samchin/sound2haptic/electronics/v2-soundcard-haptic-driver/altium/Project Outputs for ResEnvAudioBoard/Report Board Stack/AudioPCB.xls

Board Stack Report
Stack Up |  | Layer Stack
Layer | Board Layer Stack | Name | Material | Thickness | Constant
1 |  | Top Overlay |  | 0mil
2 |  | Top Solder | Solder Resist | 1.2mil | 3.8
3 |  | Top Layer |  | 1.378mil
4 |  | Dielectric 2 | PP-006 | 8.284mil | 4.4
5 |  | GND | CF-004 | 0.598mil
6 |  | Dielectric 1 |  | 41.929mil | 4.6
7 |  | Power | CF-004 | 0.598mil
8 |  | Dielectric 3 | PP-006 | 8.284mil | 4.4
9 |  | Bottom Layer |  | 1.378mil
10 |  | Bottom Solder | Solder Resist | 1.2mil | 3.8
11 |  | Bottom Overlay |  | 0mil
 | Height : 64.849mil
