samchin/sound2haptic/electronics/v2-soundcard-haptic-driver/altium/Project Outputs for ResEnvAudioBoard/BOM/Bill of Materials-ResEnvAudioBoard(No Pop CM6206 Board).xlsx

Designator | Comment | Description | Quantity | Footprint | Manufacturer Part Number | Fitted
C1, C5, C10, C13, C19 | 10µF | CAP TANT 10UF 16V 20% 1206 | 5 | 1206 TANT CASE A | T491A106M016AT | Fitted
C2, C3, C4, C14, C16, C17, C20 | 0.1uF |  | 5 | 0603 |  | Fitted, Not Fitted
C6 | .1uF |  | 1 | 0603 |  | Fitted
C7, C8 | 6pF |  | 2 | 0603 |  | Fitted
C9 | 22 µF | CAP TANT 22UF 10% 10V 1411 | 1 | CAP POL 1411_3528 |  | Fitted
C11 | 2.2uF |  | 1 | 0603 |  | Fitted
C12, C21_C1, C21_C2, C21_C3, C21_C4, C21_C5, C21_C6, C21_C7, C21_C8, C22_C1, C22_C2, C22_C3, C22_C4, C22_C5, C22_C6, C22_C7, C22_C8, C23_C1, C23_C2, C23_C3, C23_C4, C23_C5, C23_C6, C23_C7, C23_C8, C24_C1, C24_C2, C24_C3, C24_C4, C24_C5, C24_C6, C24_C7, C24_C8, C25_C1, C25_C2, C25_C3, C25_C4, C25_C5, C25_C6, C25_C7, C25_C8, C26_C1, C26_C2, C26_C3, C26_C4, C26_C5, C26_C6, C26_C7, C26_C8, C27, C28, C29 | 1uF |  | 52 | 0603 |  | Fitted
C15, C18 | 10uF | CAP TANT 10UF 16V 20% 1206 | 2 | 1206 TANT CASE A | T491A106M016AT | Fitted
D1, D2 | MM3Z5V6ST1G | DIODE ZENER 5.6V 300MW SOD323 | 2 | FP-477-02-MFG |  | Fitted
D3 | LTST-C190KGKT | LED GREEN CLEAR 0603 SMD | 1 | LED_LTST-C190 | LTST-C190KGKT | Fitted
D4 | LB Q39G-L2OO-35-1 | LED BLUE DIFFUSED 0603 SMD | 1 | LB Q39G_BLUE | LB Q39G-L2OO-35-1 | Fitted
D5 | 5V | WE-TVS TVS Diode – High Speed Series, SOT23-5L, 2+1 Channel, 5V, 2pF | 1 | WE-TVS_SOT23-5L | 824011 | Fitted
FB1, FB2 | BLM18KG601SN1D | Chip Ferrite Bead, 0603, 600Ω @ 100MHz, 0.15Ω, 25%, 1.3A | 2 | FP-BLM18-0_15-t0_8-IPC_A |  | Fitted
FB3, FB4, FB5 | 742792609 |  | 3 | WE-CBF_0603_L1.6W0.8H0.8_HC |  | Fitted
J1 | UJ2-BH-W1-TH | 3 µin Plating Thickness, White Insulator, USB Receptacle | 0 | CUI_UJ2-BH-W1-TH |  | Not Fitted
J1_C1, J1_C2, J1_C3, J1_C4, J1_C5, J1_C6, J1_C7, J1_C8 | 1881558 |  | 0 | 1881558 |  | Not Fitted
J2 | TS-106-T-A | No Description Available | 0 | CON6_1X6_TU_HTS_SAI |  | Not Fitted
J3 | M20-9990246 | CONN HEADER VERT 2POS 2.54MM | 0 | FP-M20-9990246-MFG | M20-9990246 | Not Fitted
JP1 | 2 way jumper |  | 0 | 0603 2 way jumper |  | Not Fitted
Q1 | DMG2301L-7 | MOSFET P-CH 20V 3A SOT23 | 1 | FP-SOT23-MFG | DMG2301L-7 | Fitted
R1, R2 | 22 |  | 2 | 0603 |  | Fitted
R3 | 1k |  | 1 | 0603 |  | Fitted
R4, R5 | 330 |  | 2 | 0603 |  | Fitted
R6 | 63.4k |  | 1 | 0603 |  | Fitted
R7 | 10k |  | 1 | 0603 |  | Fitted
R8 | 1.5k |  | 1 | 0603 |  | Fitted
R9_C1, R9_C2, R9_C3, R9_C4, R9_C5, R9_C6, R9_C7, R9_C8, R10_C1, R10_C2, R10_C3, R10_C4, R10_C5, R10_C6, R10_C7, R10_C8, R12_C1, R12_C2, R12_C3, R12_C4, R12_C5, R12_C6, R12_C7, R12_C8 | 20k |  | 24 | 0603 |  | Fitted
R11_C1, R11_C2, R11_C3, R11_C4, R11_C5, R11_C6, R11_C7, R11_C8 | 0.25 |  | 8 | 0805_HV |  | Fitted
R13_C1, R13_C2, R13_C3, R13_C4, R13_C5, R13_C6, R13_C7, R13_C8 | 0 |  | 8 | 0603 |  | Fitted
S1, S2, S3, S4 | B3S-1000 |  | 4 | B3S-1000_OMR |  | Fitted
TP1, TP2, TP3, TP4, TP5, TP6, TP7, TP8, TP9, TP10, TP11, TP12, TP13, TP14, TP15, TP16, TP17_C1, TP17_C2, TP17_C3, TP17_C4, TP17_C5, TP17_C6, TP17_C7, TP17_C8 | 5001 | TEST POINT PC MINI .040"D BLACK | 24 | Testpoint pad | 5001 | Fitted
U1 | CM6206 |  | 0 | CM6206 LQFP48 |  | Not Fitted
U2 | 93C46C-I/SN | 1K, 128x8 or 64x16-bit, 5.0V Microwire Serial EEPROM, 8-Pin SOIC 150mil, Industrial Temperature | 0 | SOIC-SN8_N |  | Not Fitted
U3_C1, U3_C2, U3_C3, U3_C4, U3_C5, U3_C6, U3_C7, U3_C8 | TPA6211A1DGN | 3.1-W, mono, analog input Class-AB audio amplifier | 8 | SOP65P490X110-9N |  | Fitted
U4_C1, U4_C2, U4_C3, U4_C4, U4_C5, U4_C6, U4_C7, U4_C8 | INA180A1IDBVT | 26V, 350kHz current sense amplifier | 8 | SOT95P280X145-5N |  | Fitted
U5 | TLV75801PDBVR | 500-mA, low-IQ, high-accuracy, adjustable ultra-low-dropout voltage regulator with enable | 1 | SOT95P280X145-5N |  | Fitted
U6 | 113991054 | - ESP32-C3 Transceiver; 802.11 a/b/g/n (Wi-Fi, WiFi, WLAN), BluetoothÂ® Smart 4.x Low Energy (BLE) 2.4GHz Evaluation Board | 0 | 113991054 |  | Not Fitted
U7 | AP2127K-3.3TRG1 | IC REG LINEAR 3.3V 300MA SOT23-5 | 1 | FP-SOT25-MFG | AP2127K-3.3TRG1 | Fitted
X1 | ECS-120-8-36-CKM-TR3 | No Description Available | 1 | ECS-120-8_ECS |  | Fitted
