samchin/sound2haptic/electronics/v1-haptic-driver/haptics_driver.step

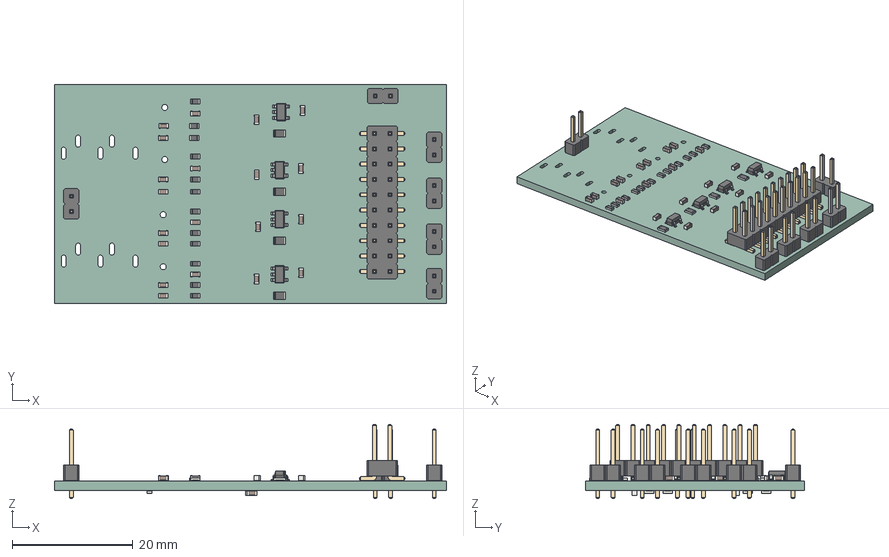
[picture p1: CAD file, 2025-09-18]
electronics/v1-haptic-driver/haptics_driver.step
65.0 x 36.3 x 12.3 mm
C_0603_1608Metric x 22
R_0603_1608Metric x 16
R_0805_2012Metric x 4
SOT_23_5 x 4
PinHeader_1x02_P254mm_Vertical x 6
PinHeader_2x10_P254mm_Vertical_SMD
haptics_driver_PCB
