samchin/sound2haptic/electronics/v2-soundcard-haptic-driver/case/case-body.stl

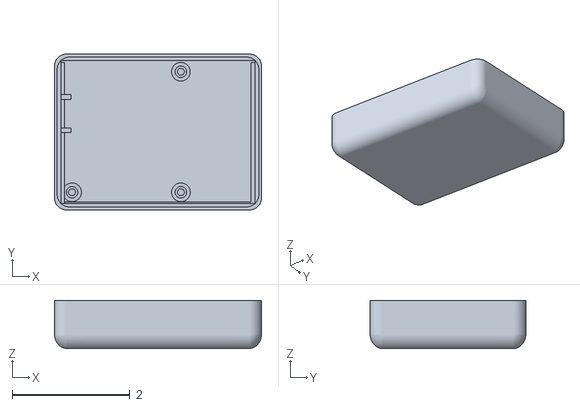
[picture p2: CAD file, 2025-09-18]
electronics/v2-soundcard-haptic-driver/case/case-body.stl
3.52 x 2.65 x 0.818
