samchin/sound2haptic/electronics/v2-soundcard-haptic-driver/case/case-cap.stl

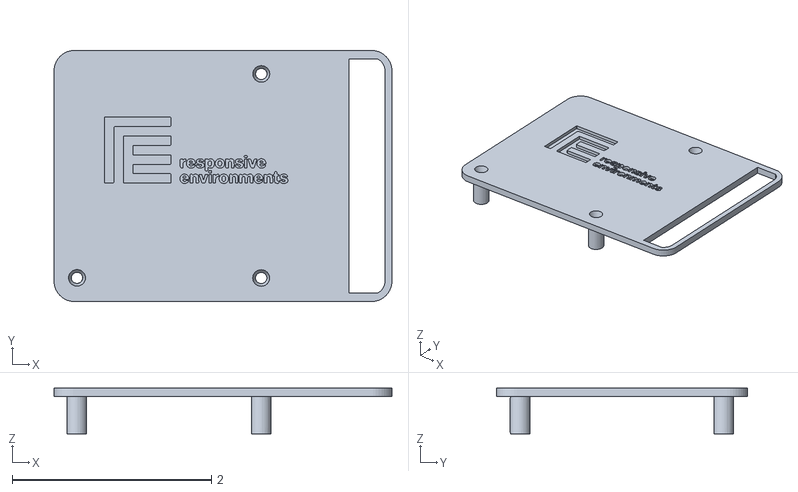
[picture p3: CAD file, 2025-09-18]
electronics/v2-soundcard-haptic-driver/case/case-cap.stl
3.39 x 2.52 x 0.46
