samchin/sound2haptic/electronics/v2-soundcard-haptic-driver/altium/Project Outputs for ResEnvAudioBoard/Job1.PDF

Designator | Comment | Description | Quantity | Footprint | Manufacturer Part Number | Fitted
C1, C5, C10, C13, C19 | 10µF | CAPTANT10UF16V 20%1206 | | 5 1206TANTCASEA | T491A106M016AT | Fitted
C2, C3, C4, C14, C16, C17, C20 | 0.1uF | | | 5 0603 | | Fitted, Not Fitted
C6 | .1uF | | | 1 0603 | | Fitted
C7, C8 | 6pF | | | 2 0603 | | Fitted
C9 | 22µF | CAPTANT22UF10% 10V1411 | | 1 CAPPOL1411_3528 | | Fitted
C11 | 2.2uF | | | 1 0603 | | Fitted
C12, C21_C1, C21_C2, C21_C3, C21_C4, C21_C5, C21_C6, C21_C7, C21_C8, C22_C1, C22_C2, C22_C3, C22_C4, C22_C5, C22_C6, C22_C7, C22_C8, C23_C1, C23_C2, C23_C3, C23_C4, C23_C5, C23_C6, C23_C7, C23_C8, C24_C1, C24_C2, C24_C3, C24_C4, C24_C5, C24_C6, C24_C7, C24_C8, C25_C1, C25_C2, C25_C3, C25_C4, C25_C5, C25_C6, C25_C7, C25_C8, C26_C1, C26_C2, C26_C3, C26_C4, C26_C5, C26_C6, C26_C7, C26_C8, C27, C28, C29 | 1uF | | 52 | 0603 | | Fitted
C15, C18 | 10uF | CAPTANT10UF16V 20%1206 | | 2 1206TANTCASEA | T491A106M016AT | Fitted
D1, D2 | MM3Z5V6ST1G | DIODEZENER5.6V 300MWSOD323 | | 2 FP-477-02-MFG | | Fitted
D3 | LTST-C190KGKT | LEDGREENCLEAR 0603SMD | | 1 LED_LTST-C190 | LTST-C190KGKT | Fitted
D4 | LBQ39G-L2OO-35-1 | LEDBLUEDIFFUSED 0603SMD | | 1 LBQ39G_BLUE | LBQ39G-L2OO-35-1 | Fitted
D5 | 5V | WE-TVSTVSDiode– HighSpeedSeries, SOT23-5L, 2+1 Channel, 5V, 2pF | | 1 WE-TVS_SOT23-5L | 824011 | Fitted
FB1, FB2 | BLM18KG601SN1D | ChipFerriteBead, 0603, 600Ω@ 100MHz, 0.15Ω, 25%, 1.3A | | 2 FP-BLM18-0_15-t0_8-IPC_A | | Fitted
FB3, FB4, FB5 | 742792609 | | | WE-3 CBF_0603_L1.6W0.8H 0.8_HC | | Fitted
J1 | UJ2-BH-W1-TH | 3µinPlating Thickness, White Insulator, USB Receptacle | | 0 CUI_UJ2-BH-W1-TH | | Not Fitted
J1_C1, J1_C2, J1_C3, J1_C4, J1_C5, J1_C6, J1_C7, J1_C8 | 1881558 | | | 0 1881558 | | Not Fitted
J2 | TS-106-T-A | NoDescription Available | | 0 CON6_1X6_TU_HTS_S AI | | Not Fitted
J3 | M20-9990246 | CONNHEADERVERT 2POS2.54MM | | 0 FP-M20-9990246-MFG | M20-9990246 | Not Fitted
JP1 | 2wayjumper | | | 0 06032wayjumper | | Not Fitted
Q1 | DMG2301L-7 | MOSFETP-CH20V3A SOT23 | | 1 FP-SOT23-MFG | DMG2301L-7 | Fitted
R1, R2 | 22 | | | 2 0603 | | Fitted
R3 | 1k | | | 1 0603 | | Fitted
R4, R5 | 330 | | | 2 0603 | | Fitted
R6 | 63.4k | | | 1 0603 | | Fitted
R7 | 10k | | | 1 0603 | | Fitted
R8 | 1.5k | | | 1 0603 | | Fitted
R9_C1, R9_C2, R9_C3, R9_C4, R9_C5, R9_C6, R9_C7, R9_C8, R10_C1, R10_C2, R10_C3, R10_C4, R10_C5, R10_C6, R10_C7, R10_C8, R12_C1, R12_C2, R12_C3, R12_C4, R12_C5, R12_C6, R12_C7, R12_C8 | 20k | | 24 | 0603 | | Fitted
R11_C1, R11_C2, R11_C3, R11_C4, R11_C5, R11_C6, R11_C7, R11_C8 | 0.25 | | | 8 0805_HV | | Fitted
R13_C1, R13_C2, R13_C3, R13_C4, R13_C5, R13_C6, R13_C7, R13_C8 | 0 | | | 8 0603 | | Fitted
S1, S2, S3, S4 | B3S-1000 | | | 4 B3S-1000_OMR | | Fitted
TP1, TP2, TP3, TP4, TP5, TP6, TP7, TP8, TP9, TP10, TP11, TP12, TP13, TP14, TP15, TP16, TP17_C1, TP17_C2, TP17_C3, TP17_C4, TP17_C5, TP17_C6, TP17_C7, TP17_C8 | 5001 | TESTPOINTPCMINI .040"DBLACK | 24 | Testpoint pad | 5001 | Fitted
U1 | CM6206 | | | 0 CM6206LQFP48 | | Not Fitted
U2 | 93C46C-I/SN | 1K, 128x8or 64x16-bit, 5.0VMicrowireSerial EEPROM, 8-PinSOIC 150mil, Industrial Temperature | | 0 SOIC-SN8_N | | Not Fitted
U3_C1, U3_C2, U3_C3, U3_C4, U3_C5, U3_C6, U3_C7, U3_C8 | TPA6211A1DGN | 3.1-W, mono, analog input Class-ABaudio amplifier | | 8 SOP65P490X110-9N | | Fitted
U4_C1, U4_C2, U4_C3, U4_C4, U4_C5, U4_C6, U4_C7, U4_C8 | INA180A1IDBVT | 26V, 350kHzcurrent senseamplifier | | 8 SOT95P280X145-5N | | Fitted
U5 | TLV75801PDBVR | 500-mA, low-IQ, high-accuracy, adjustable ultra-low-dropout voltageregulator with enable | | 1 SOT95P280X145-5N | | Fitted
U6 | 113991054 | - ESP32-C3 Transceiver; 802.11 a/b/g/n(Wi-Fi, WiFi, WLAN), BluetoothÂ® Smart 4.xLowEnergy (BLE)2.4GHz EvaluationBoard | | 0 113991054 | | Not Fitted
U7 | AP2127K-3.3TRG1 | ICREGLINEAR3.3V 300MASOT23-5 | | 1 FP-SOT25-MFG | AP2127K-3.3TRG1 | Fitted
X1 | ECS-120-8-36-CKM-TR3 | NoDescription Available | | 1 ECS-120-8_ECS | | Fitted

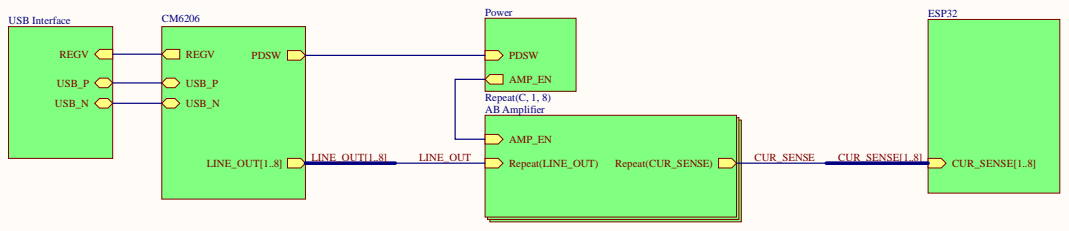
[picture p4: page 2]

DWG. NO. | REV. | SHT.

THIS DOCUMENT AND THE DATA DISCLOSED HEREIN OR HEREWITH IS THE PROPERTY OF ALTIUM LIMITED AND MAY BE FREELY DISTRIBUTED IN WHOLE. NO RIGHTS ARE RESERVED OR EXPRESS OR IMPLIED WARANTEE GIVEN. | Power ESP32 | REVISION | DESCRIPTION | DATE | APPROVED

REV. SHT. DWG. NO.

DATE | PROJECT * | ADDRESS 1 ADDRESS 2 APPROVALS ADDRESS 3 ADDRESS 4

ENG: * | --/--/--

DSN: * | --/--/--

PROJECT REVISION: | DOCUMENT REVISION: | DESIGN ITEM:

CHK: * | --/--/--

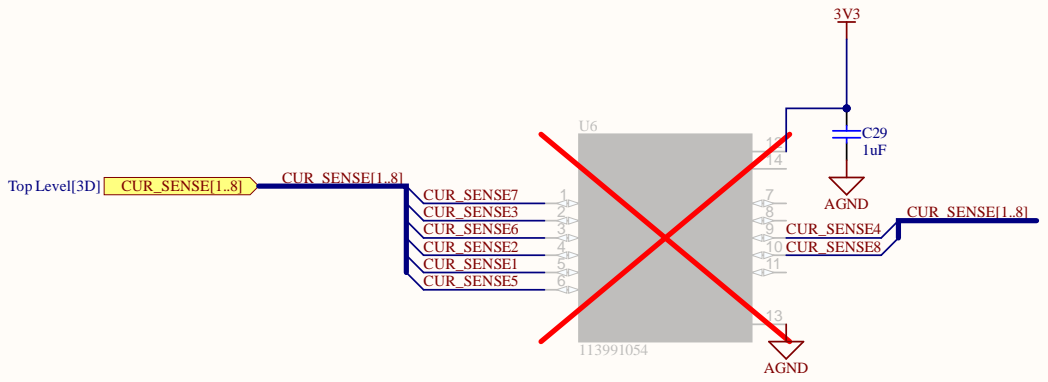
[picture p5: page 3]

DWG . N O . | R E V | . S H T.

T H IS DOC U MEN T AN D T HE D ATA D ISCLOSED HEREI N OR HEREW I T H IS T HE PROPER TY OF ALT I U M LI M I TED AN D M AY BE F REELY D IST R IBU TED I N W HOLE. NO R IGH TS ARE RESERVED OR EXPRESS OR I MPLIED WARAN TEE GIVEN . | | REVISI ON | DESCRIPTI ON | DATE | APPROVED

REV. SHT. DWG. NO.

DATE | PRO JECT * | AD D RESS 1 2 APPROVALS AD D RESS AD D RESS 3 AD D RESS 4

ENG : | --/--/--
** DSN: | --/--/--

PRO JECT REVISION: 773a96068f66e7145c3ca330ce66923ed7e94 9f84d95b09577287ed89ef6d54d535716cc81 b31 | DOCUMENT REVISION: | DESIGN ITEM :

CHK: * | --/--/--

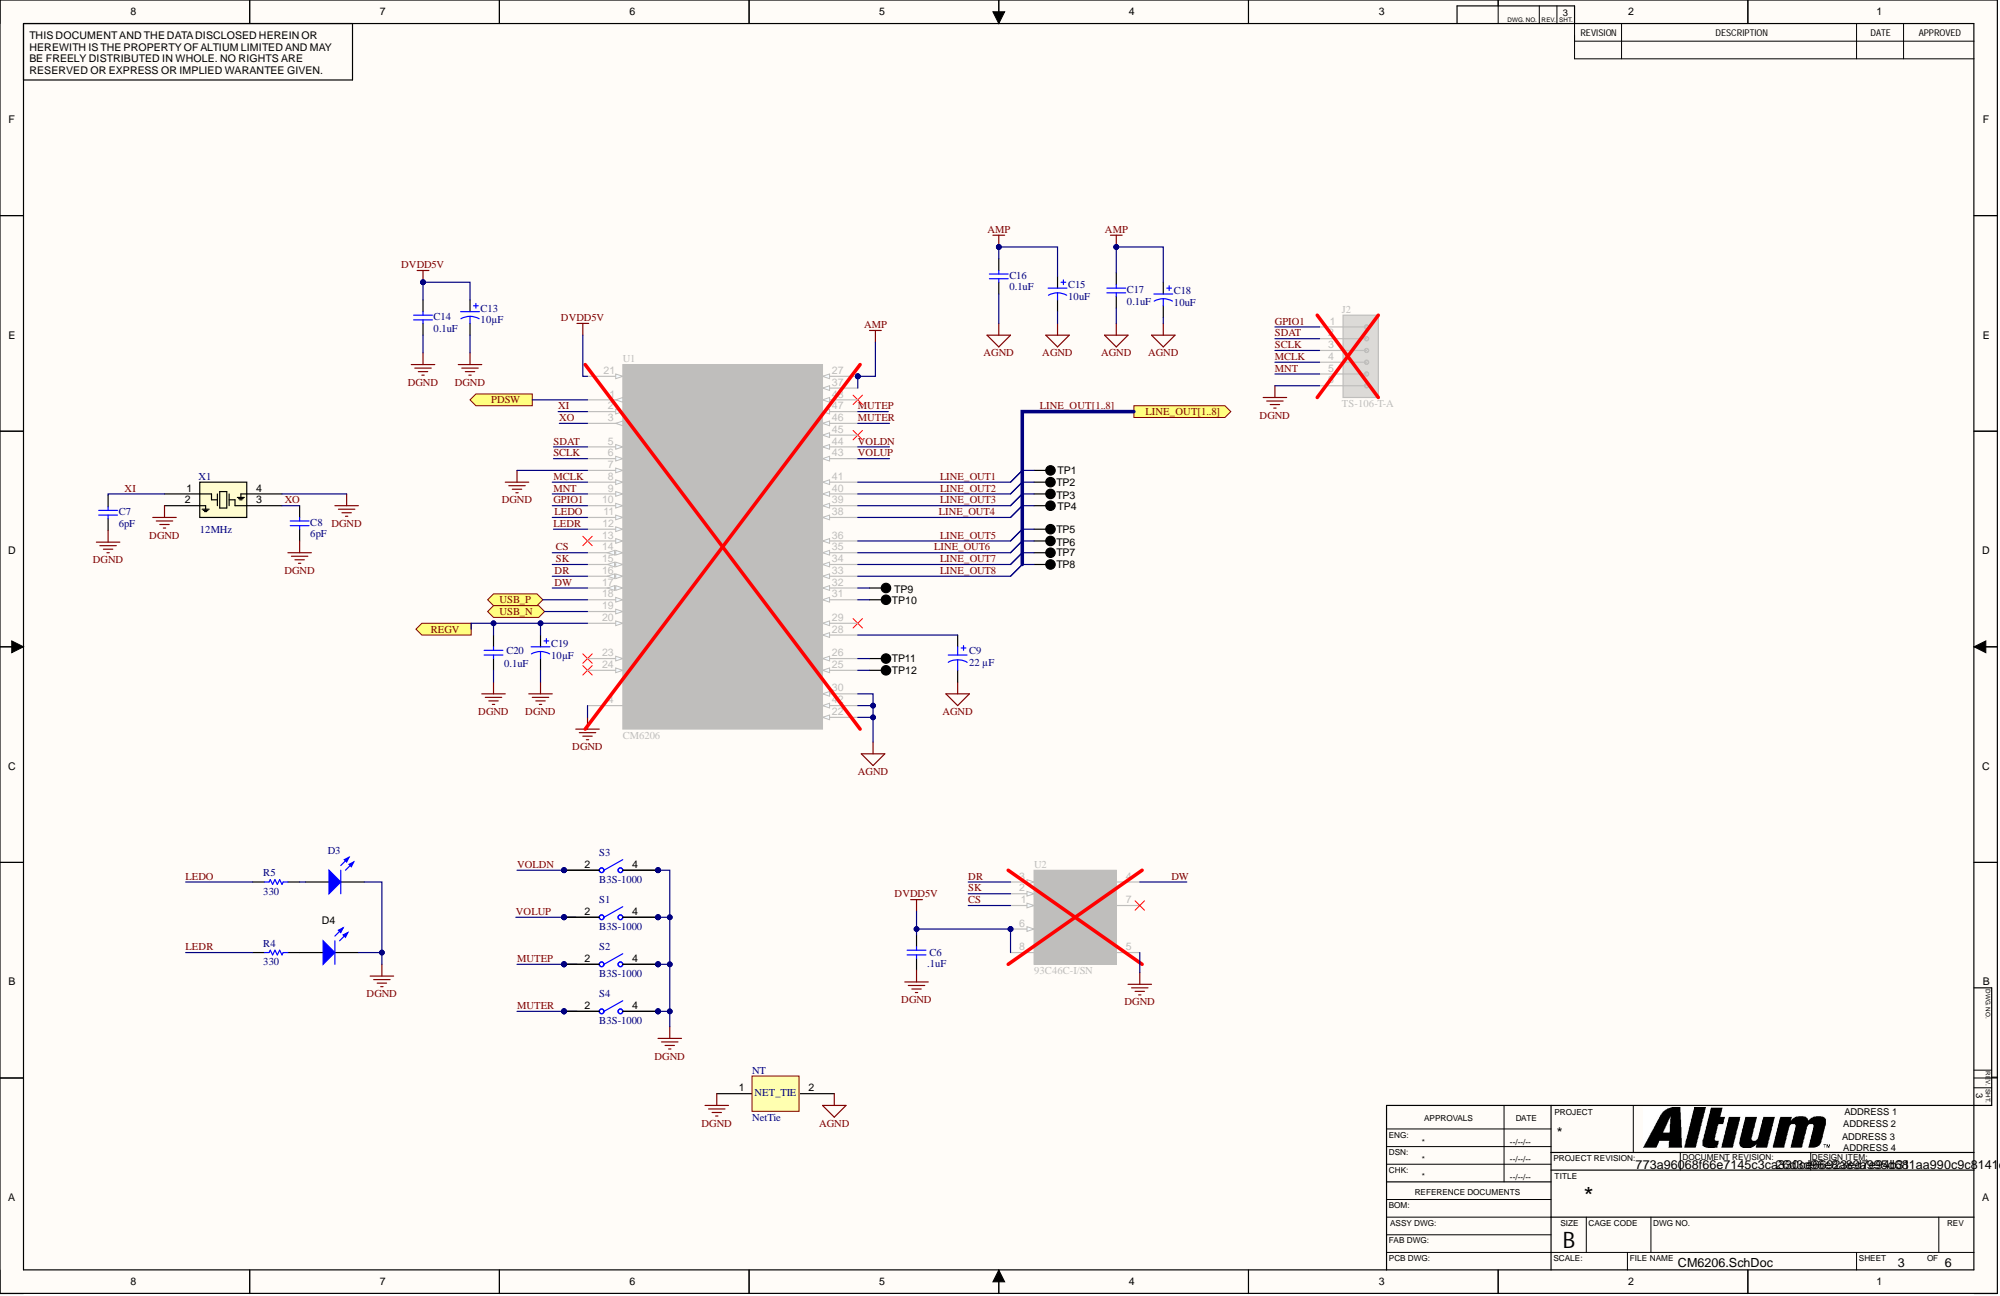
[picture p6: page 4]

REV. SHT. DWG. NO.

DATE | PROJECT * | ADDRESS 1 ADDRESS 2 APPROVALS ADDRESS 3 ADDRESS 4

ENG: * | --/--/--

DSN: * | --/--/--

PROJECT REVISION: | DOCUMENT REVISION: | DESIGN ITEM:

CHK: * | --/--/--

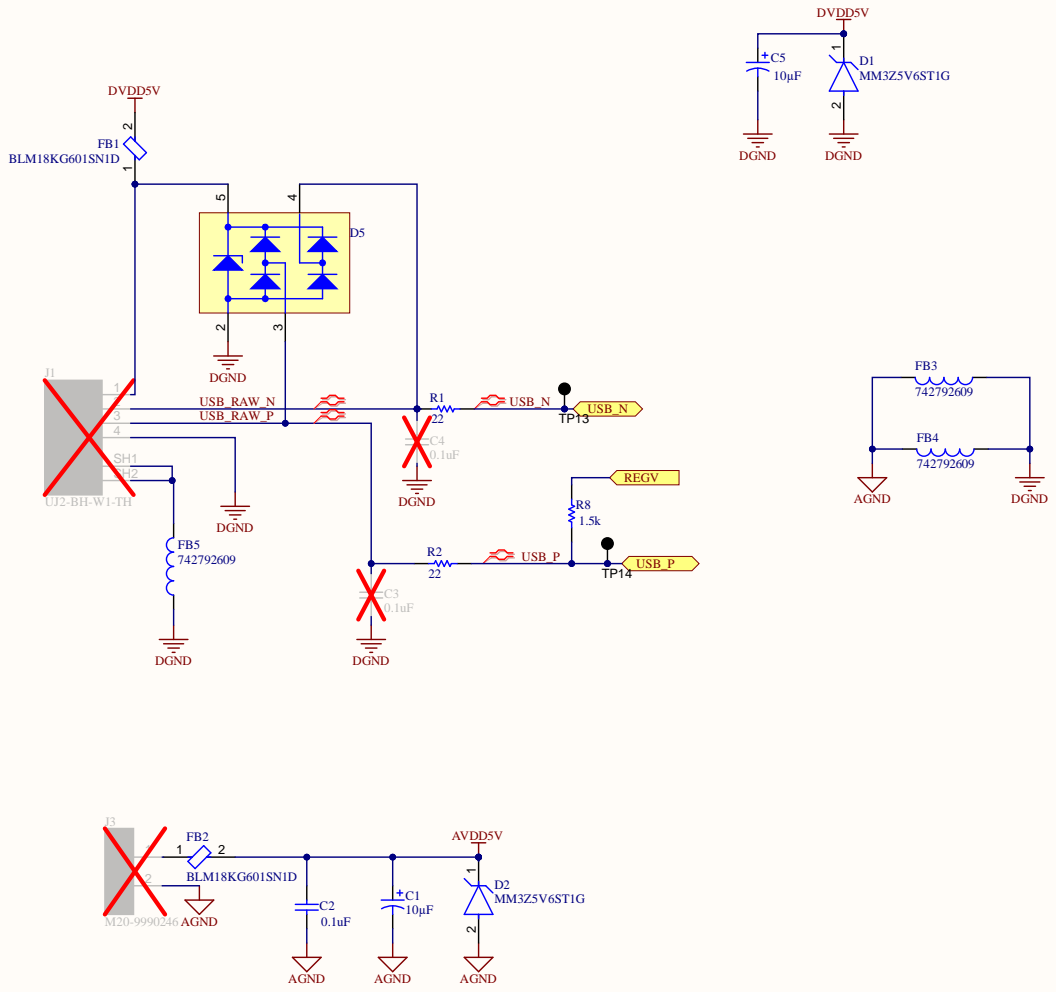
[picture p7: page 5]

REV. SHT. DWG. NO.

DATE | PROJECT * | ADDRESS 1 ADDRESS 2 APPROVALS ADDRESS 3 ADDRESS 4

ENG: * | --/--/--

DSN: * | --/--/--

PROJECT REVISION: | DOCUMENT REVISION: | DESIGN ITEM:

CHK: * | --/--/--

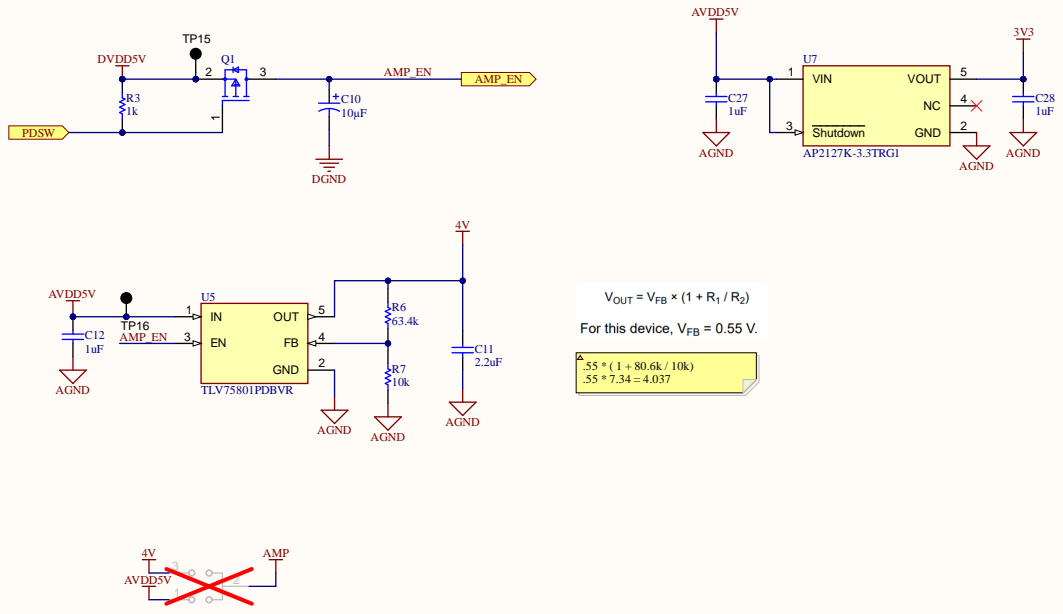
[picture p8: page 6]

REV. SHT. DWG. NO.

DATE | PROJECT * | ADDRESS 1 ADDRESS 2 APPROVALS ADDRESS 3 ADDRESS 4

ENG: * | --/--/--

DSN: * | --/--/--

PROJECT REVISION: | DOCUMENT REVISION: | DESIGN ITEM:

CHK: * | --/--/--

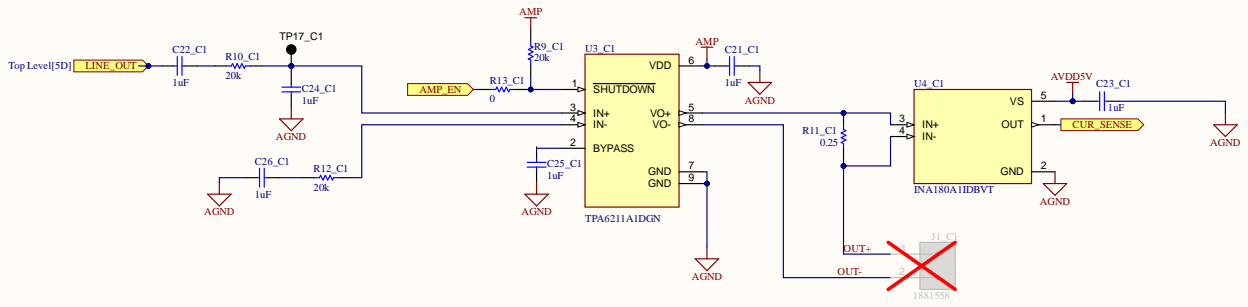
[picture p9: page 7]

REV. SHT. DWG. NO.

DATE | PROJECT * | ADDRESS 1 ADDRESS 2 APPROVALS ADDRESS 3 ADDRESS 4

ENG: * | --/--/--

DSN: * | --/--/--

PROJECT REVISION: | DOCUMENT REVISION: | DESIGN ITEM:

CHK: * | --/--/--

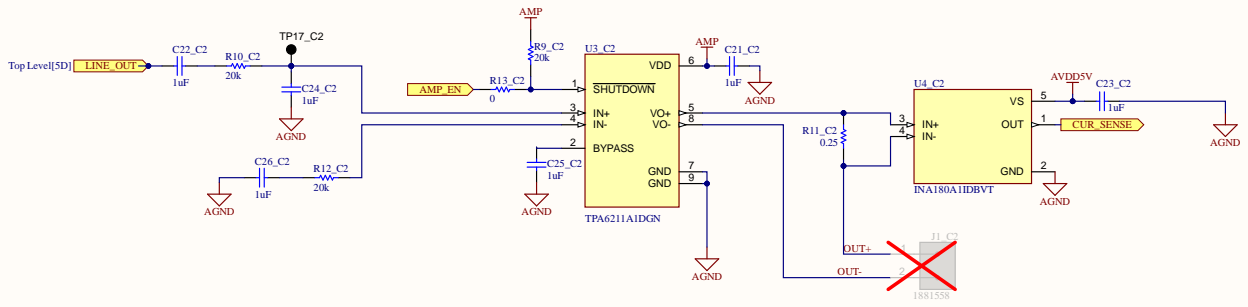
[picture p10: page 8]

REV. SHT. DWG. NO.

DATE | PROJECT * | ADDRESS 1 ADDRESS 2 APPROVALS ADDRESS 3 ADDRESS 4

ENG: * | --/--/--

DSN: * | --/--/--

PROJECT REVISION: | DOCUMENT REVISION: | DESIGN ITEM:

CHK: * | --/--/--

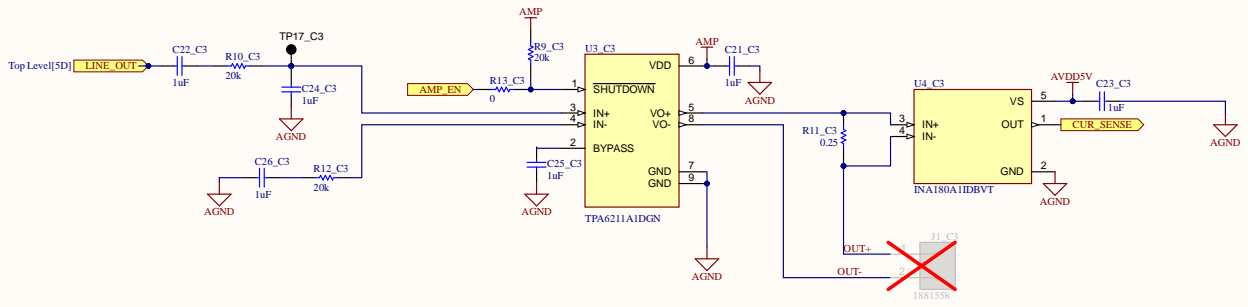
[picture p11: page 9]

REV. SHT. DWG. NO.

DATE | PROJECT * | ADDRESS 1 ADDRESS 2 APPROVALS ADDRESS 3 ADDRESS 4

ENG: * | --/--/--

DSN: * | --/--/--

PROJECT REVISION: | DOCUMENT REVISION: | DESIGN ITEM:

CHK: * | --/--/--

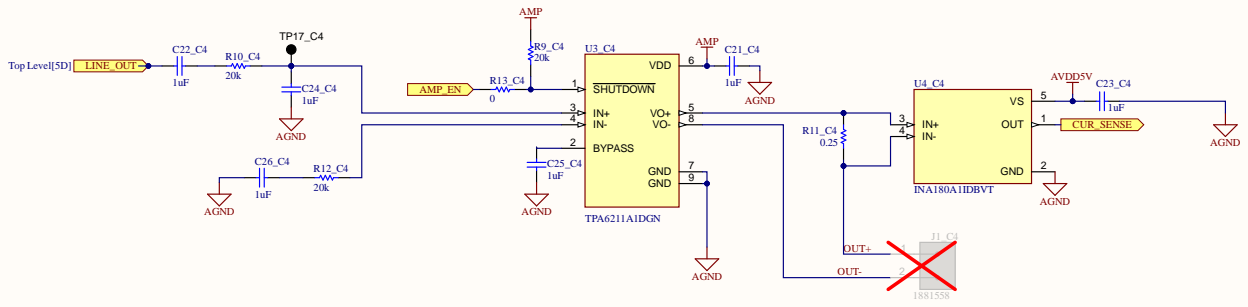
[picture p12: page 10]

REV. SHT. DWG. NO.

DATE | PROJECT * | ADDRESS 1 ADDRESS 2 APPROVALS ADDRESS 3 ADDRESS 4

ENG: * | --/--/--

DSN: * | --/--/--

PROJECT REVISION: | DOCUMENT REVISION: | DESIGN ITEM:

CHK: * | --/--/--

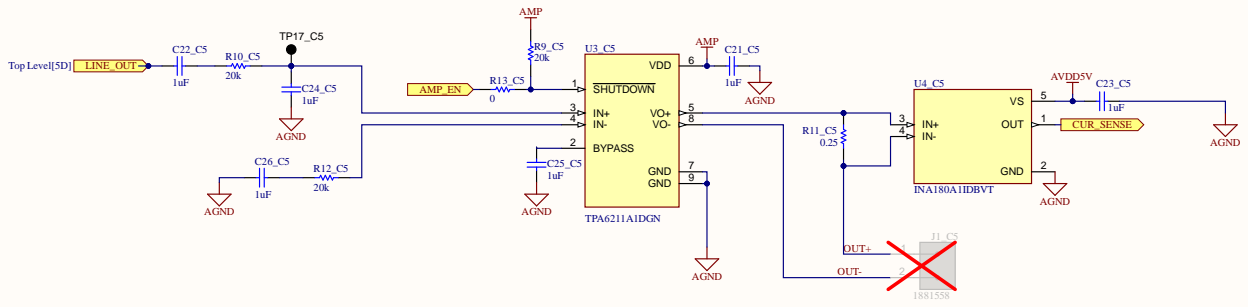
[picture p13: page 11]

REV. SHT. DWG. NO.

DATE | PROJECT * | ADDRESS 1 ADDRESS 2 APPROVALS ADDRESS 3 ADDRESS 4

ENG: * | --/--/--

DSN: * | --/--/--

PROJECT REVISION: | DOCUMENT REVISION: | DESIGN ITEM:

CHK: * | --/--/--

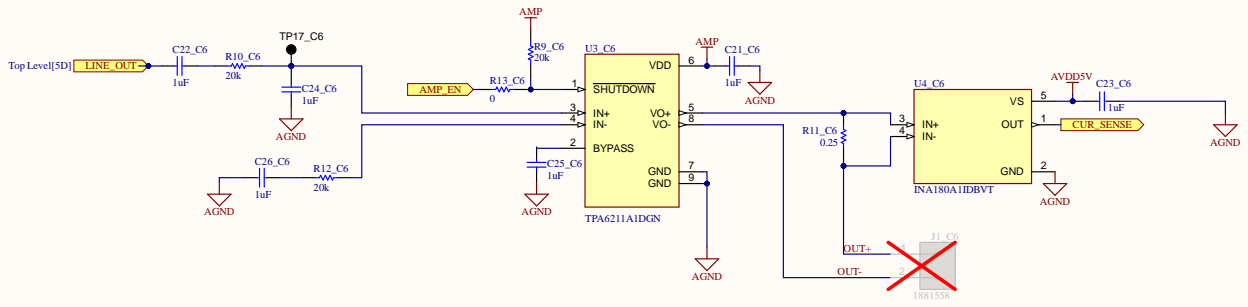
[picture p14: page 12]

REV. SHT. DWG. NO.

DATE | PROJECT * | ADDRESS 1 ADDRESS 2 APPROVALS ADDRESS 3 ADDRESS 4

ENG: * | --/--/--

DSN: * | --/--/--

PROJECT REVISION: | DOCUMENT REVISION: | DESIGN ITEM:

CHK: * | --/--/--

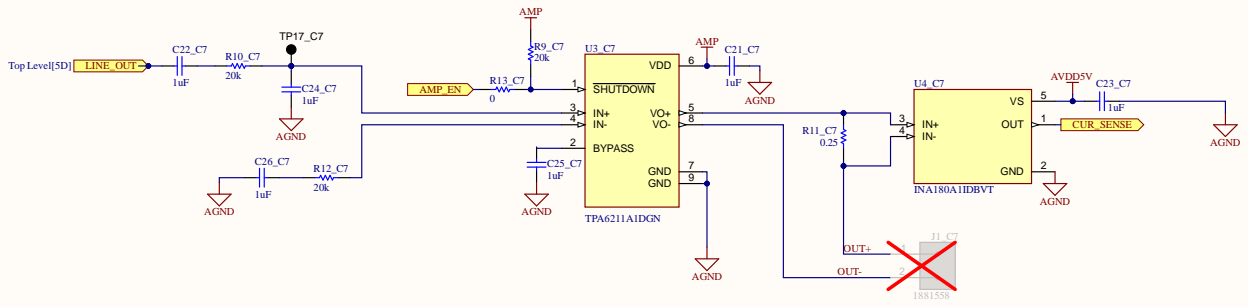
[picture p15: page 13]

REV. SHT. DWG. NO.

DATE | PROJECT * | ADDRESS 1 ADDRESS 2 APPROVALS ADDRESS 3 ADDRESS 4

ENG: * | --/--/--

DSN: * | --/--/--

PROJECT REVISION: | DOCUMENT REVISION: | DESIGN ITEM:

CHK: * | --/--/--

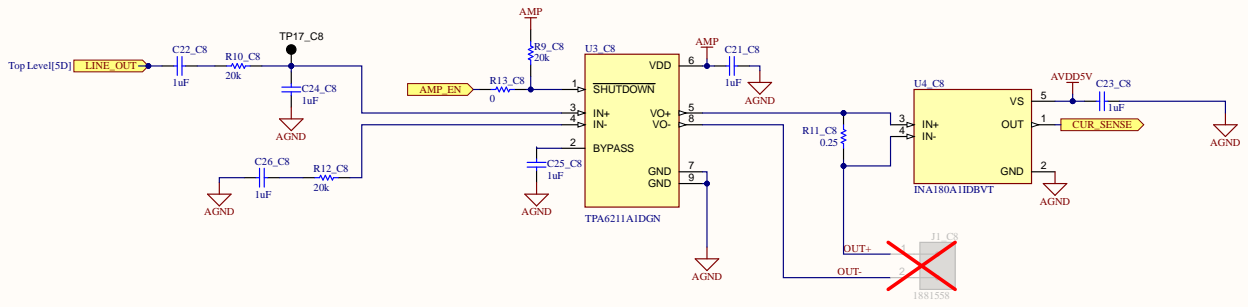
[picture p16: page 14]

DWG . N O . | R E V | . S H T.

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

REV. SHT. DWG. NO.

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

ENG : | --/--/--
** DSN: | --/--/--

PRO JECT REVISION: 773a96068f66e7145c3ca330ce66923ed7e94 087441a9074096e245bc2ab2b33784aac6aec b31 | DOCUMENT REVISION: | DESIGN ITEM :

CHK: * | --/--/--
