samchin/sound2haptic/(list of files, drawings)

Other design files:
electronics/v2-soundcard-haptic-driver/altium/AB Amplifier.SchDoc
electronics/v2-soundcard-haptic-driver/altium/AudioPCB.PcbDoc
electronics/v2-soundcard-haptic-driver/altium/CM6206.SchDoc
electronics/v2-soundcard-haptic-driver/altium/ESP32.SchDoc
electronics/v2-soundcard-haptic-driver/altium/PcbLib1.PcbLib
electronics/v2-soundcard-haptic-driver/altium/Power.SchDoc
electronics/v2-soundcard-haptic-driver/altium/ResEnvAudioBoard.PrjPcb
electronics/v2-soundcard-haptic-driver/altium/SamlibSCH.SchLib
electronics/v2-soundcard-haptic-driver/altium/Schlib1.SchLib
electronics/v2-soundcard-haptic-driver/altium/Top Level.SchDoc
electronics/v2-soundcard-haptic-driver/altium/USB Interface.SchDoc
