samchin/sound2haptic/electronics/v1-haptic-driver/haptics_driver.kicad_pcb

## KiCad design electronics/v1-haptic-driver/haptics_driver.kicad_pcb (2025-09-18)

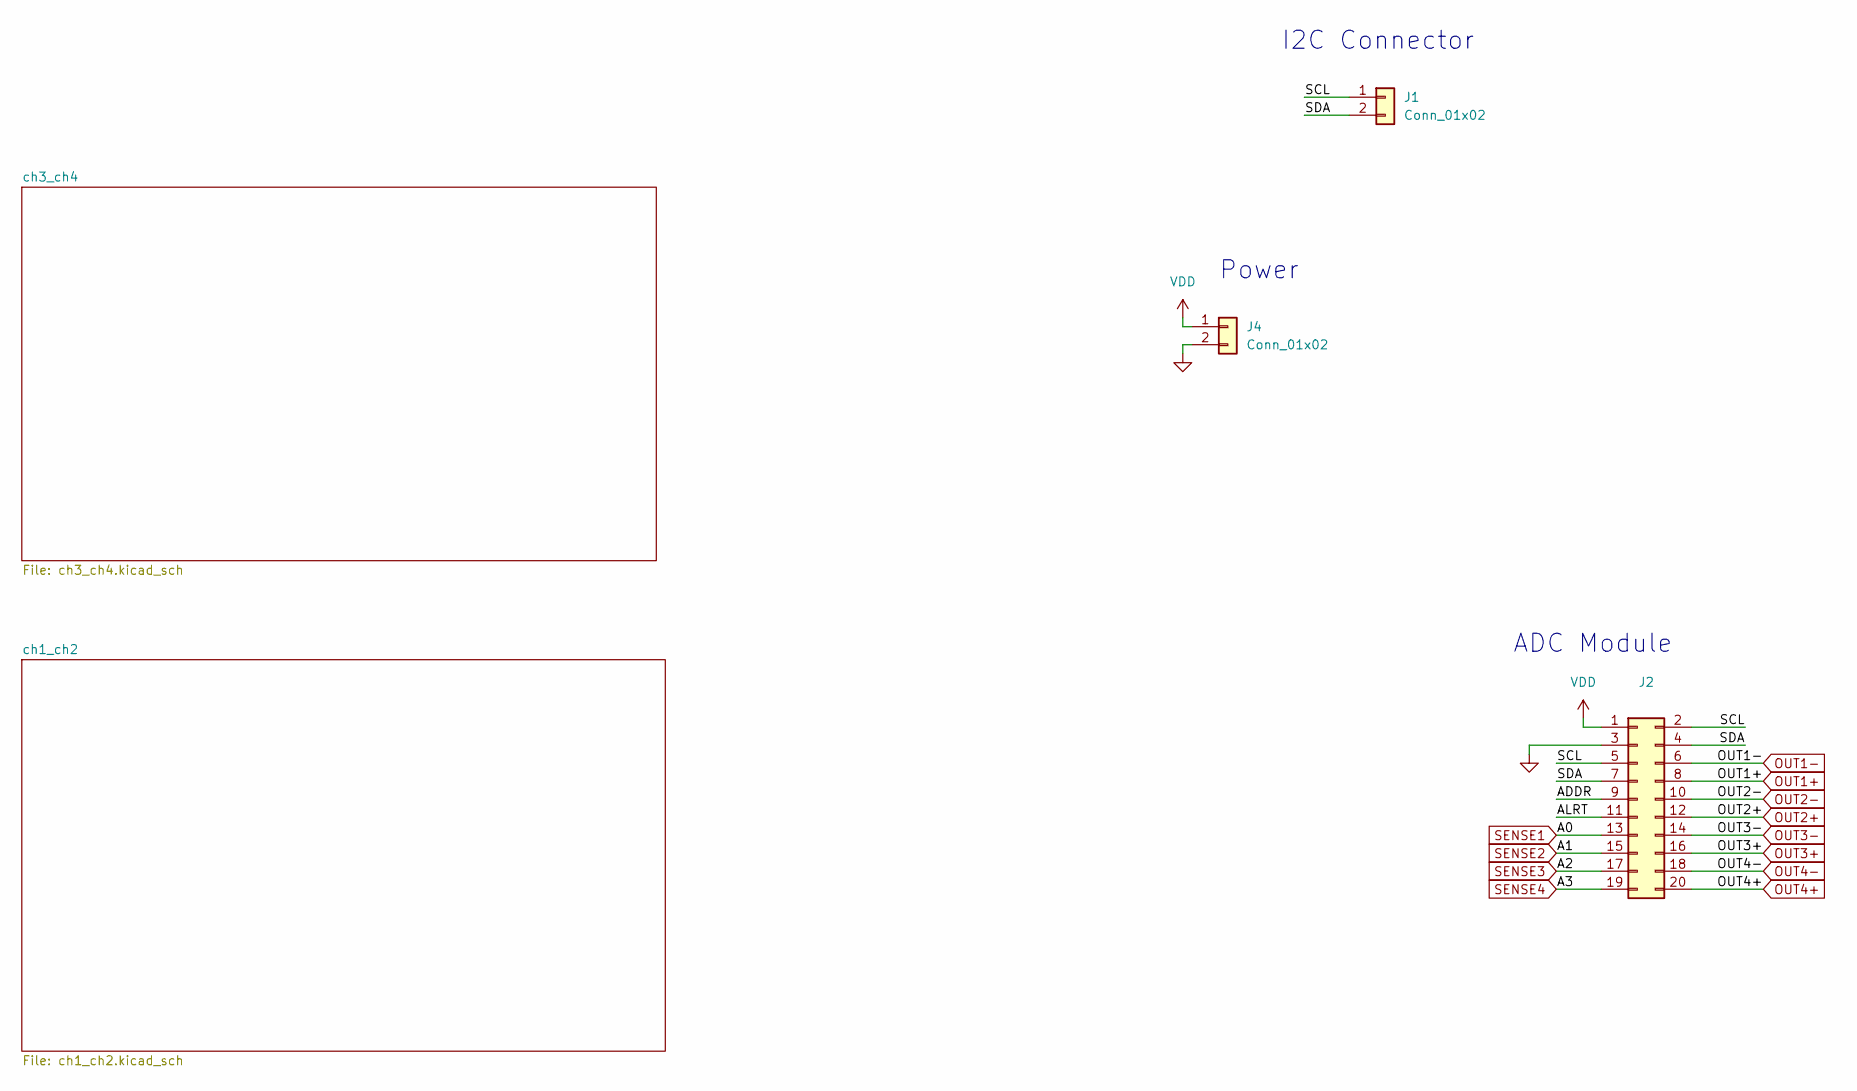
[picture p17: schematic haptics_driver.kicad_sch]

Parts:
J1, J4: Conn_01x02; PinHeader_1x02_P2.54mm_Vertical
J2: Conn_02x10_Odd_Even; PinHeader_2x10_P2.54mm_Vertical_SMD

Connections:
/ADDR: J2.9
/ALRT: J2.11
/SCL: J1.1, J2.2, J2.5
/SDA: J1.2, J2.4, J2.7
GND: J2.3, J4.2; also elsewhere on the board
OUT1+: J2.8; also elsewhere on the board
OUT1-: J2.6; also elsewhere on the board
OUT2+: J2.12; also elsewhere on the board
OUT2-: J2.10; also elsewhere on the board
OUT3+: J2.16; also elsewhere on the board
OUT3-: J2.14; also elsewhere on the board
OUT4+: J2.20; also elsewhere on the board
OUT4-: J2.18; also elsewhere on the board
SENSE1: J2.13; also elsewhere on the board
SENSE2: J2.15; also elsewhere on the board
SENSE3: J2.17; also elsewhere on the board
SENSE4: J2.19; also elsewhere on the board
VDD: J2.1, J4.1; also elsewhere on the board

Notes on the sheet:
ADC Module
Power
I2C Connector

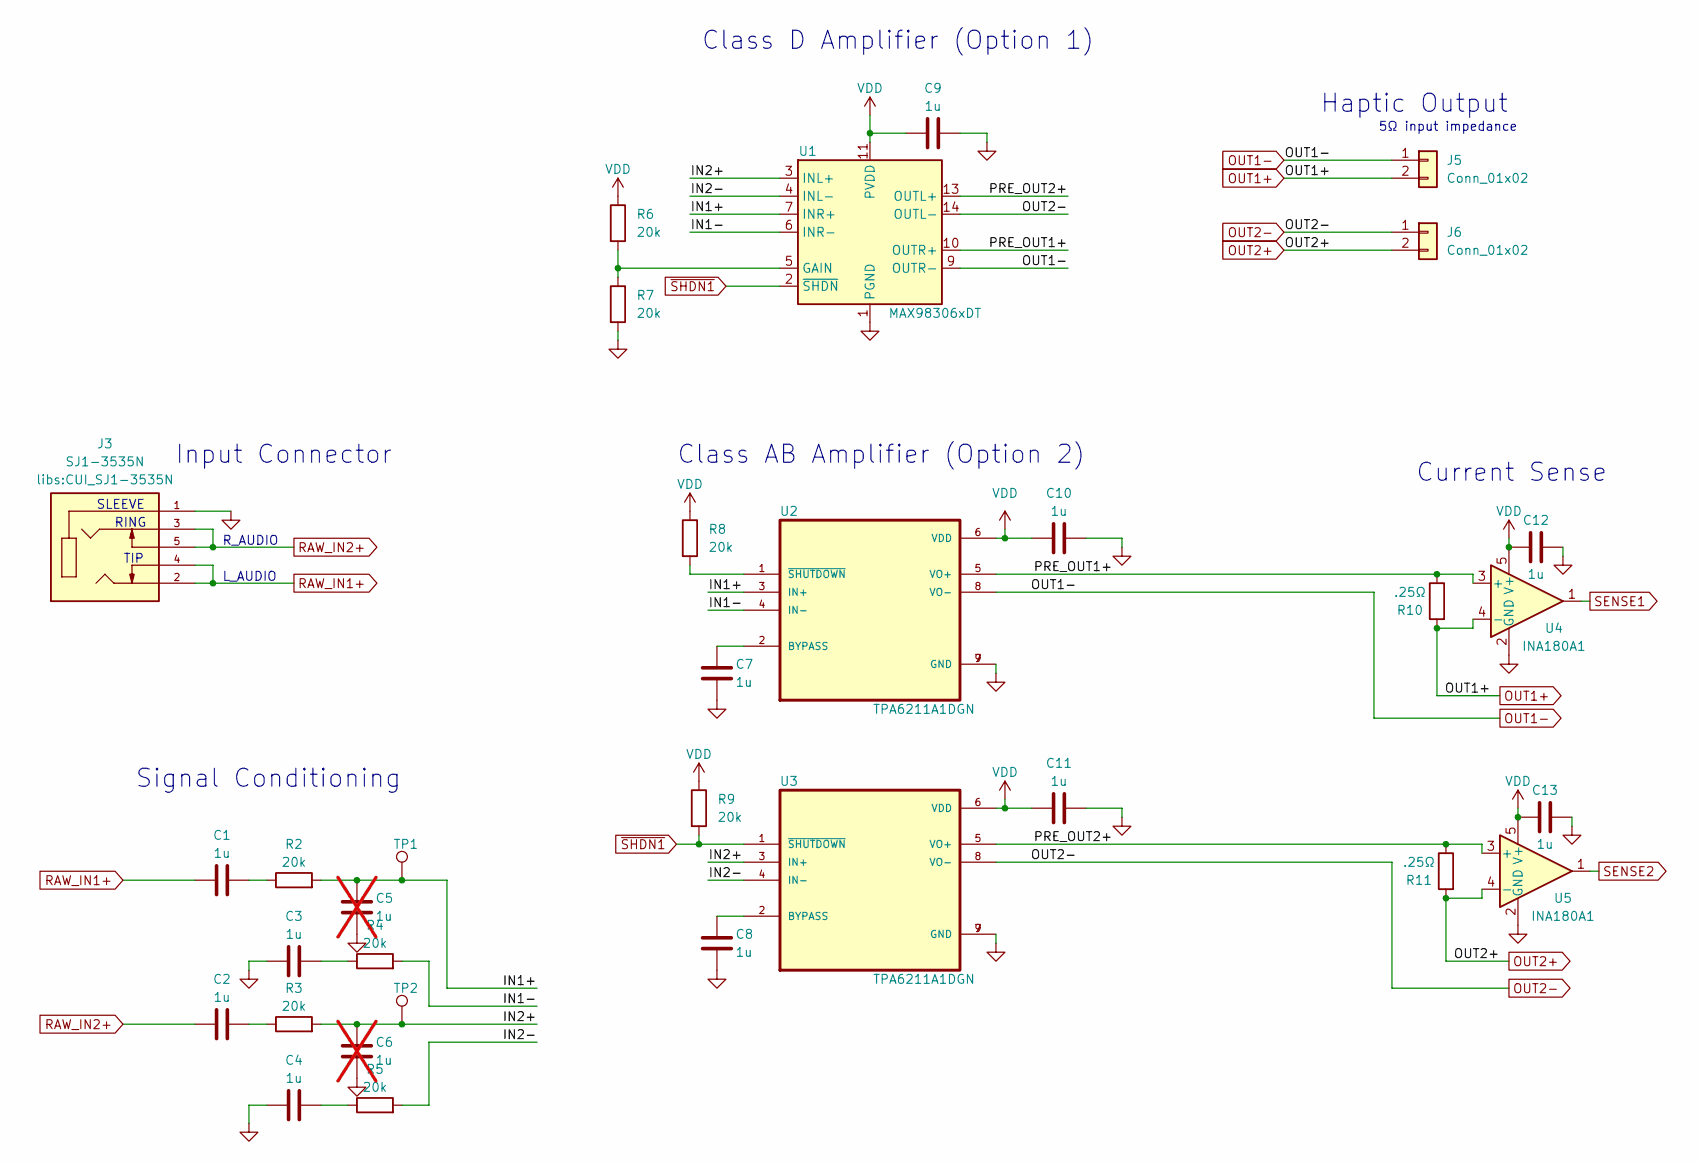
[picture p18: schematic ch1_ch2.kicad_sch]

Parts:
C1, C2, C3, C4, C7, C8, C9, C10, C11, C12, C13: 1u; C_0603_1608Metric
C5, C6: 1u; C_0603_1608Metric; not fitted
J3: SJ1-3535N; CUI_SJ1-3535N; PARTREV 1.03
J5, J6: Conn_01x02; PinHeader_1x02_P2.54mm_Vertical
R2, R3, R4, R5, R6, R7, R8, R9: 20k; R_0603_1608Metric
R10, R11: .25Ω; R_0805_2012Metric
TP1, TP2: TestPoint; TestPoint_THTPad_2.0x2.0mm_Drill1.0mm
U1: MAX98306xDT; TDFN-14-1EP_3x3mm_P0.4mm_EP1.78x2.35mm
U2, U3: TPA6211A1DGN; SOP65P490X110-9N
U4, U5: INA180A1; SOT-23-5

Connections:
/ch1_ch2/IN1+: C5.1, R2.2, TP1.1, U1.7 (INR+), U2.3 (IN+)
/ch1_ch2/IN1-: R4.2, U1.6 (INR-), U2.4 (IN-)
/ch1_ch2/IN2+: C6.1, R3.2, TP2.1, U1.3 (INL+), U3.3 (IN+)
/ch1_ch2/IN2-: R5.2, U1.4 (INL-), U3.4 (IN-)
/ch1_ch2/PRE_OUT1+: R10.1, U1.10 (OUTR+), U2.5 (VO+), U4.3 (+)
/ch1_ch2/PRE_OUT2+: R11.1, U1.13 (OUTL+), U3.5 (VO+), U5.3 (+)
GND: C3.1, C4.1, C5.2, C6.2, C7.2, C8.2, C9.2, C10.2, C11.2, C12.2, C13.2, J3.1, R7.2, U1.1 (PGND), U1.8 (PGND), U1.15 (PGND), U2.7 (GND), U2.9 (GND), U3.7 (GND), U3.9 (GND), U4.2 (GND), U5.2 (GND); also elsewhere on the board
unnamed: C1.2, R2.1
unnamed: C2.2, R3.1
unnamed: C3.2, R4.1
unnamed: C4.2, R5.1
unnamed: R6.2, R7.1, U1.5 (GAIN)
unnamed: C7.1, U2.2 (BYPASS)
unnamed: R8.2, U2.1 (~SHUTDOWN)
unnamed: C8.1, U3.2 (BYPASS)
OUT1+: J5.2, R10.2, U4.4 (-); also elsewhere on the board
OUT1-: J5.1, U1.9 (OUTR-), U2.8 (VO-); also elsewhere on the board
OUT2+: J6.2, R11.2, U5.4 (-); also elsewhere on the board
OUT2-: J6.1, U1.14 (OUTL-), U3.8 (VO-); also elsewhere on the board
RAW_IN1+: C1.1, J3.2, J3.4
RAW_IN2+: C2.1, J3.3, J3.5
SENSE1: U4.1; also elsewhere on the board
SENSE2: U5.1; also elsewhere on the board
VDD: C9.1, C10.1, C11.1, C12.1, C13.1, R6.1, R8.1, R9.1, U1.11 (PVDD), U1.12 (PVDD), U2.6 (VDD), U3.6 (VDD), U4.5 (V+), U5.5 (V+); also elsewhere on the board
~SHDN1: R9.2, U1.2 (~SHDN), U3.1 (~SHUTDOWN)

Notes on the sheet:
Signal Conditioning
RING
5Ω input impedance
Input Connector
TIP
Current Sense
Class AB Amplifier (Option 2)
SLEEVE
R_AUDIO
Haptic Output
Class D Amplifier (Option 1)
L_AUDIO

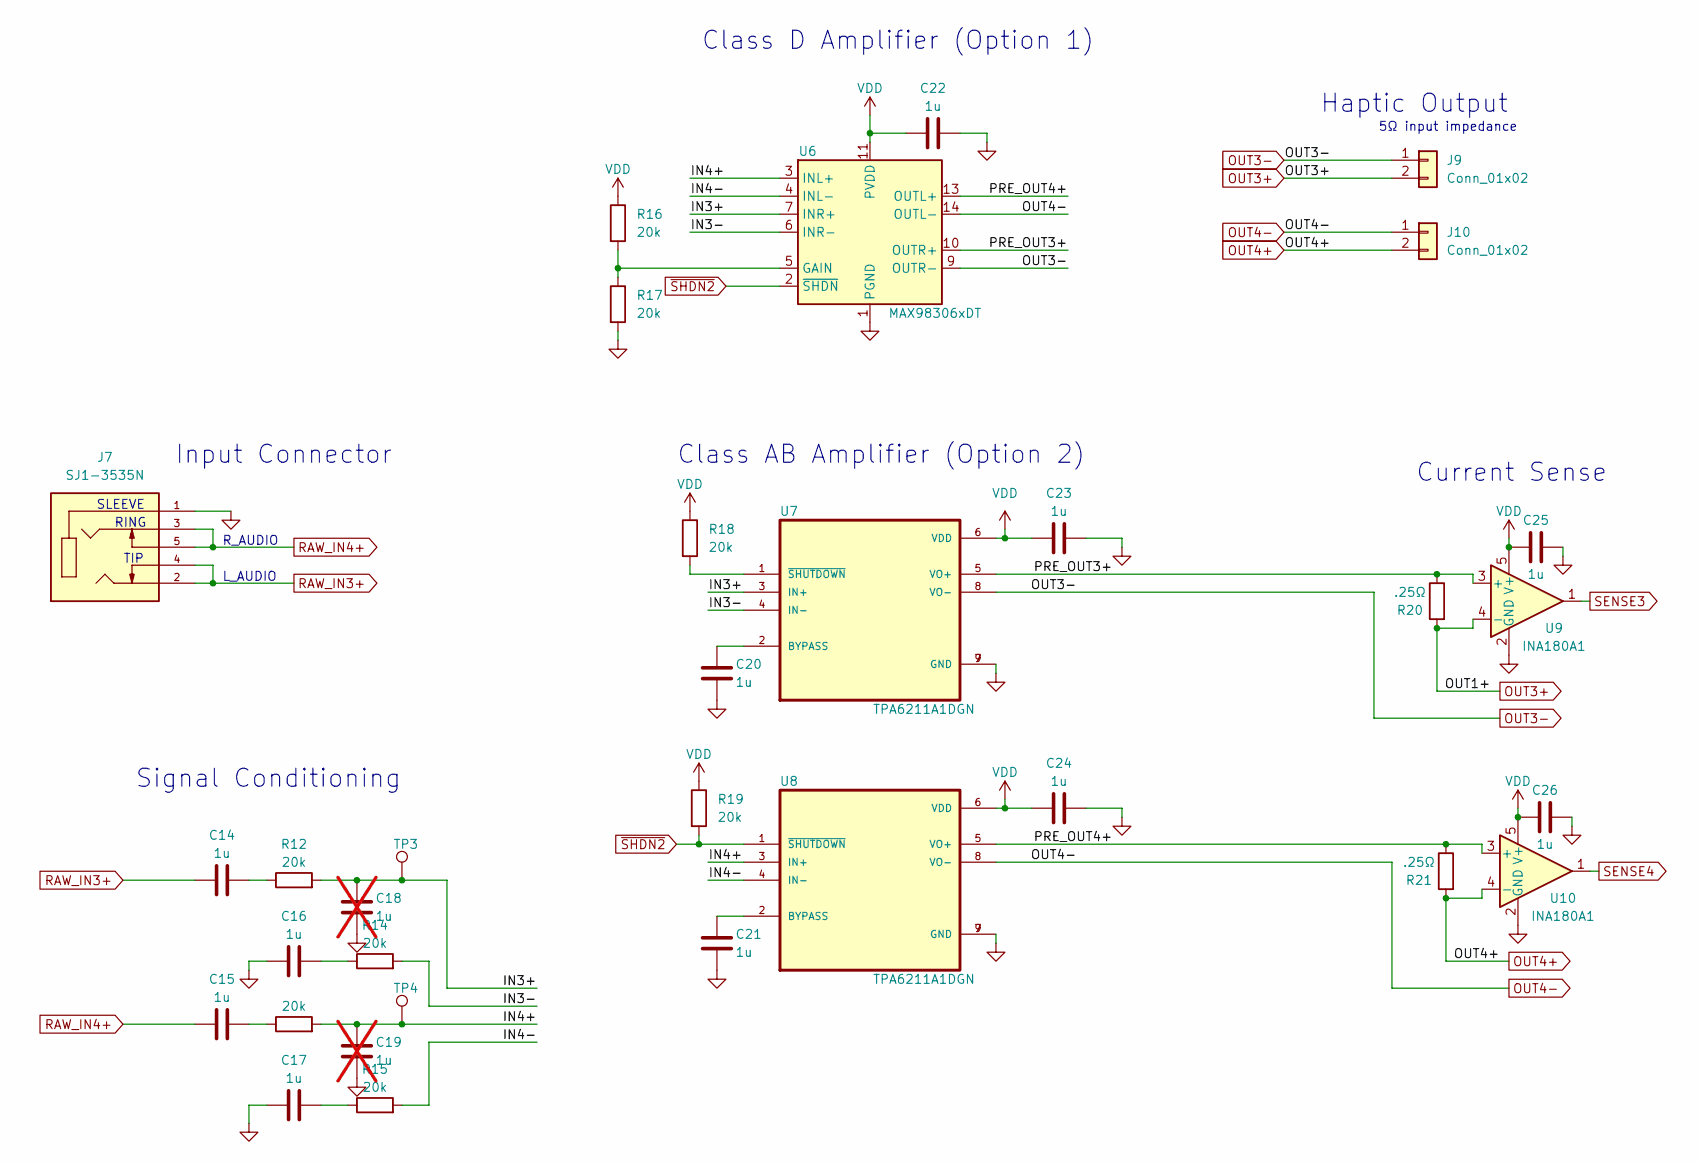
[picture p19: schematic ch3_ch4.kicad_sch]

Parts:
C14, C15, C16, C17, C20, C21, C22, C23, C24, C25, C26: 1u; C_0603_1608Metric
C18, C19: 1u; C_0603_1608Metric; not fitted
J7: SJ1-3535N; CUI_SJ1-3535N; PARTREV 1.03
J9, J10: Conn_01x02; PinHeader_1x02_P2.54mm_Vertical
R12, R13, R14, R15, R16, R17, R18, R19: 20k; R_0603_1608Metric
R20, R21: .25Ω; R_0805_2012Metric
TP3, TP4: TestPoint; TestPoint_THTPad_2.0x2.0mm_Drill1.0mm
U6: MAX98306xDT; TDFN-14-1EP_3x3mm_P0.4mm_EP1.78x2.35mm
U7, U8: TPA6211A1DGN; SOP65P490X110-9N
U9, U10: INA180A1; SOT-23-5

Connections:
/ch3_ch4/IN3+: C18.1, R12.2, TP3.1, U6.7 (INR+), U7.3 (IN+)
/ch3_ch4/IN3-: R14.2, U6.6 (INR-), U7.4 (IN-)
/ch3_ch4/IN4+: C19.1, R13.2, TP4.1, U6.3 (INL+), U8.3 (IN+)
/ch3_ch4/IN4-: R15.2, U6.4 (INL-), U8.4 (IN-)
/ch3_ch4/PRE_OUT3+: R20.1, U6.10 (OUTR+), U7.5 (VO+), U9.3 (+)
/ch3_ch4/PRE_OUT4+: R21.1, U6.13 (OUTL+), U8.5 (VO+), U10.3 (+)
GND: C16.1, C17.1, C18.2, C19.2, C20.2, C21.2, C22.2, C23.2, C24.2, C25.2, C26.2, J7.1, R17.2, U6.1 (PGND), U6.8 (PGND), U6.15 (PGND), U7.7 (GND), U7.9 (GND), U8.7 (GND), U8.9 (GND), U9.2 (GND), U10.2 (GND); also elsewhere on the board
unnamed: C14.2, R12.1
unnamed: C15.2, R13.1
unnamed: C16.2, R14.1
unnamed: C17.2, R15.1
unnamed: R16.2, R17.1, U6.5 (GAIN)
unnamed: C20.1, U7.2 (BYPASS)
unnamed: R18.2, U7.1 (~SHUTDOWN)
unnamed: C21.1, U8.2 (BYPASS)
OUT3+: J9.2, R20.2, U9.4 (-); also elsewhere on the board
OUT3-: J9.1, U6.9 (OUTR-), U7.8 (VO-); also elsewhere on the board
OUT4+: J10.2, R21.2, U10.4 (-); also elsewhere on the board
OUT4-: J10.1, U6.14 (OUTL-), U8.8 (VO-); also elsewhere on the board
RAW_IN3+: C14.1, J7.2, J7.4
RAW_IN4+: C15.1, J7.3, J7.5
SENSE3: U9.1; also elsewhere on the board
SENSE4: U10.1; also elsewhere on the board
VDD: C22.1, C23.1, C24.1, C25.1, C26.1, R16.1, R18.1, R19.1, U6.11 (PVDD), U6.12 (PVDD), U7.6 (VDD), U8.6 (VDD), U9.5 (V+), U10.5 (V+); also elsewhere on the board
~SHDN2: R19.2, U6.2 (~SHDN), U8.1 (~SHUTDOWN)

Notes on the sheet:
Signal Conditioning
RING
5Ω input impedance
Input Connector
TIP
Current Sense
Class AB Amplifier (Option 2)
SLEEVE
R_AUDIO
Haptic Output
Class D Amplifier (Option 1)
L_AUDIO

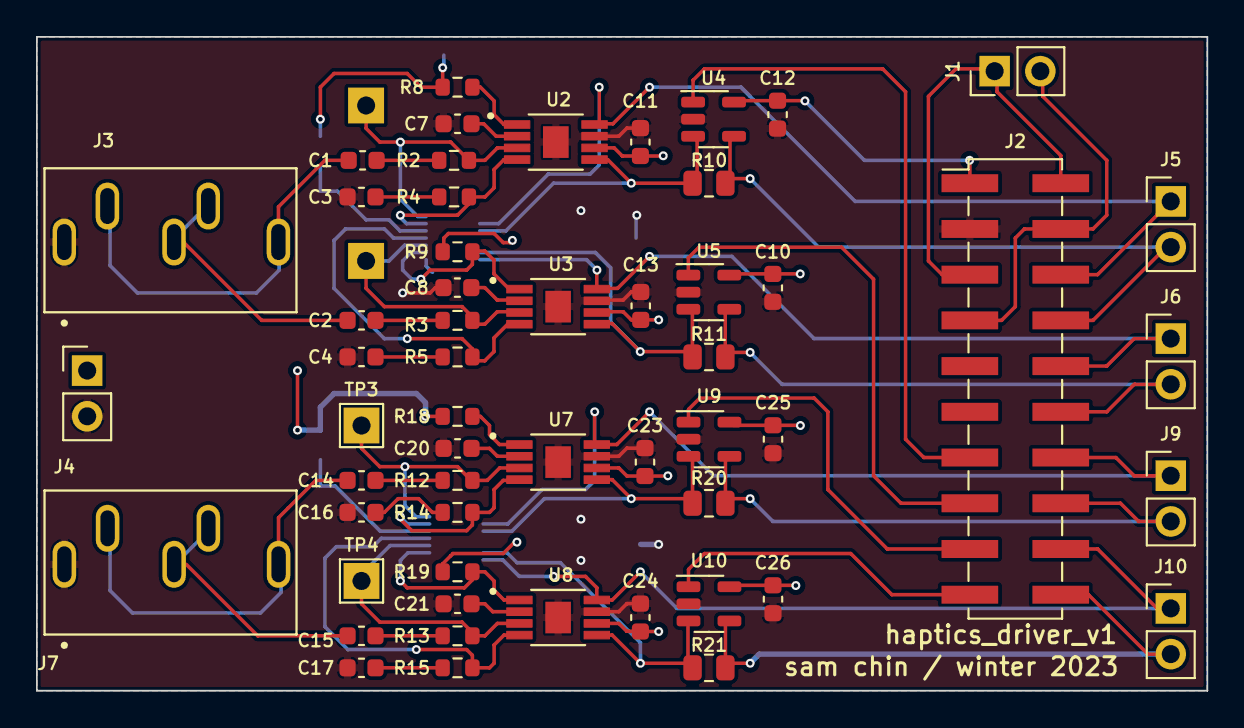
[picture p20: board haptics_driver.kicad_pcb from above]

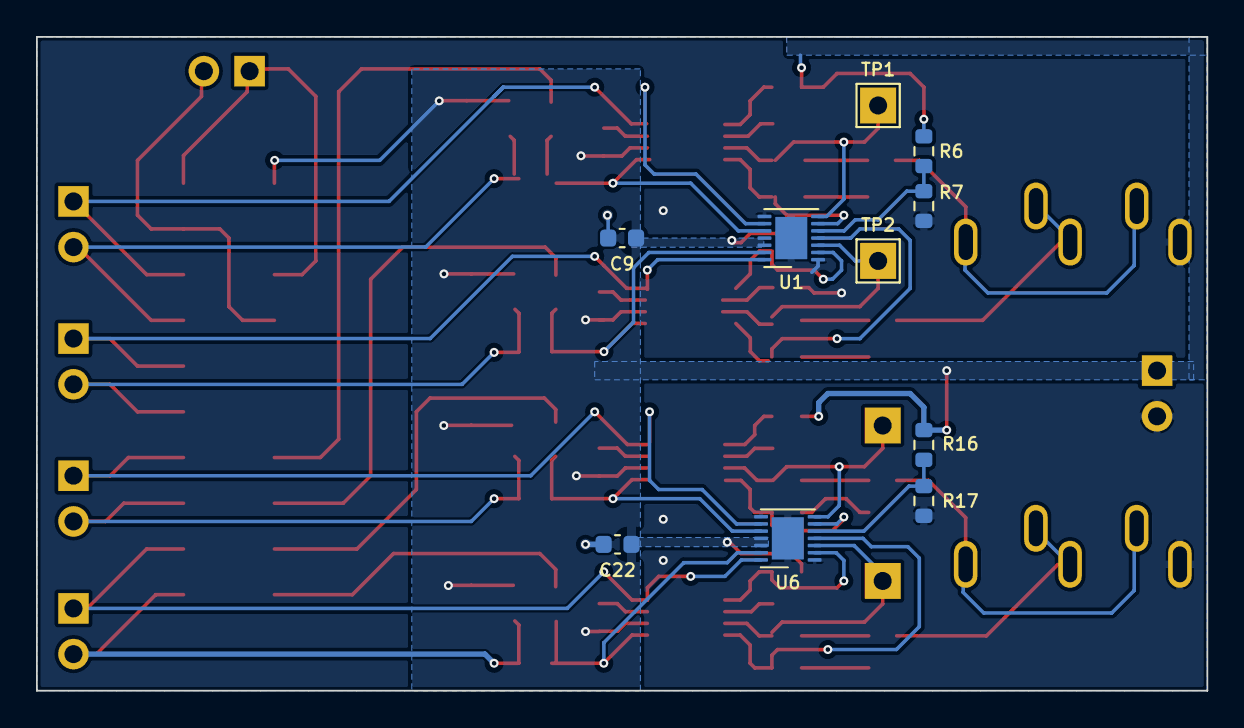
[picture p21: board haptics_driver.kicad_pcb from below]

Board: 2 copper layers, 65.0 x 36.3 mm, 65 parts (10 on the bottom side), 50 nets.
